crankyblondecoder/pico-boost/hardware/automotive_pi_pico_input_protect.ods

12V to Pico Input Calcs for ESD
 |  |  |  | Power, max supply (W)
Load Dump Max V | 120 | R1 min | 20449
-ve spike V | -150 | R1 Actual | 47000 | 0.00033
 |  | I,R1 min @ LD Max V (mA) | 1.41
Min supply V | 11.5 | R2 Actual | 100000 | 0.00070
Max supply V | 14.5 | R3 Ideal | 22936
 |  | R3 Actual | 20000 | 0.00014
Diode (1n4148) Vf @ 0.1mA | 0.5 | I,T1 @ T1 Breakdown Max (mA) | 0.97
Pin V | 3.3
 |  | D1, If @ Min Supply | 0.07
TVS Diode min current (mA) | 1 | D1, If @ Max Supply | 0.08
TVS Diode Standoff (V) | 43.6
TVS Diode Breakdown Min | 48.5 | OA v+ @ Min Supply | 1.32
TVS Diode Breakdown Max | 53.6 | OA v+ @ Max Supply | 1.68
TVS Forward Voltage | 3.5
TVS Forward Amperage | 50 | R6 min @ -ve spike | 43000
 |  | R6 Actual | 51000 | 0.00036
R1 and R6 Max Power (W) | 0.25
 |  | I,T1 @ -ve spike (mA) | 1.53
Opamp V+ | 5.0 | Vf, T1 @ -ve spike | 0.11
Opamp V- | 0.0 | OA v+ @ -ve spike | -0.0179
Opamp v+ max | 10.0
Opamp v+ min | -0.5 | R4 Actual | 20000 | 0.00035
Opamp v- ref | 0.5 | R5 Ideal | 4988
 |  | R5 Actual | 5100 | 0.00009
 |  | OA v- @ Pin (V) | 0.67
 |  | I,R4/R5 (mA) | 0.13
