crankyblondecoder/pico-boost/hardware/12v_protected_logic_input.jpg

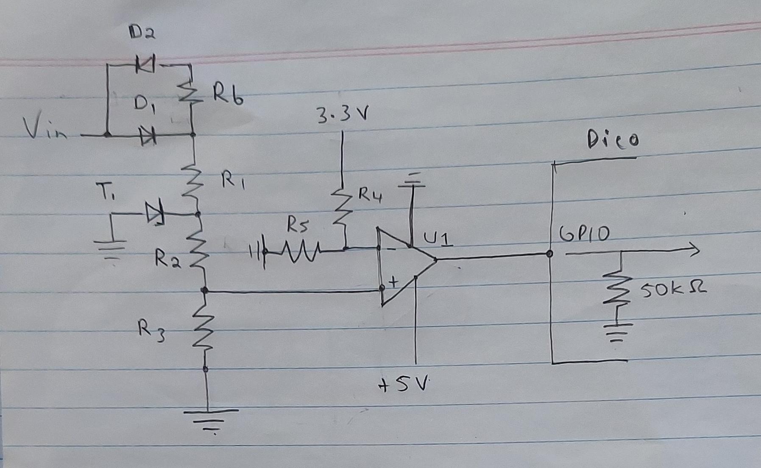
hardware/12v_protected_logic_input.jpg
