crankyblondecoder/pico-boost/src/pico_boost.cpp

#include "pico/stdlib.h"
#include <stdio.h>
#include "hardware/adc.h"
#include "hardware/gpio.h"
#include "hardware/i2c.h"
#include "hardware/regs/intctrl.h"
#include "pico/multicore.h"
#include "pico/time.h"

#include "gpioAlloc.hpp"
#include "BoostControl.hpp"
#include "BoostOptions.hpp"

/** The ADC channel used to get VSYS voltage. */
#define VSYS_REF_CHANNEL 3

#define ON_BOARD_LED_FLASH_TIME_US 500000

bool onBoardLedOn = true;
absolute_time_t lastonBoardLedToggleTime;

bool debugMsgActive = true;

// Debug flag to get around timers being a pain. Set during debug only.
bool debug = false;

/** Single boost control instance, instantiated on core 1. */
BoostControl* boostControl = 0;

BoostOptions* boostOptions = 0;

void __core1_entry();

/**
 * Program for Pi Pico that controls boost.
 */
int main()
{
	// Make sure disabled interrupts wake up WFE via the SEVONPEND flag of the SCR register.
	// See "M0PLUS: SCR Register" in RP2040 Datasheet.
	// SEVONPEND needs to be set. This allows WFE to wake up on pending interrupt even if disabled.
	uint32_t* scrRegAddr = (uint32_t*)(PPB_BASE + 0xed10);
	*scrRegAddr |= 0x10;

	// Must happen for serial stdout to work.
	stdio_init_all();

	// Setup ADC.
	adc_init();

	// Setup GPIO for boost options. Done here so it doesn't get forgotten when allocating GPIO.
	gpio_init(BOOST_OPTIONS_TEST_ACTIVE_GPIO);
	gpio_set_dir(BOOST_OPTIONS_TEST_ACTIVE_GPIO, GPIO_OUT);
	gpio_put(BOOST_OPTIONS_TEST_ACTIVE_GPIO, false);

	// Push GPIO pin 23 (SMPS Mode) high to disable power saving, which causes noise in the ADC.
	gpio_init(23);
	gpio_set_dir(23, GPIO_OUT);
	gpio_put(23, true);

	// Setup i2c bus 0.
	// Note: i2c is open drain so it requires pull up resistors on both pins.
	// Note: i2c_write_timeout_us can be used for multiple bytes. Be aware of page size write limits on the chip.
	// Note: i2c_read_timeout_us can be used for multiple bytes. Be aware of page size write limits on the chip.
	i2c_init(i2c0, 400000);

	gpio_init(I2C_BUS0_SDA_GPIO);
    gpio_set_function(I2C_BUS0_SDA_GPIO, GPIO_FUNC_I2C);
    gpio_pull_up(I2C_BUS0_SDA_GPIO);

    gpio_init(I2C_BUS0_SCL_GPIO);
    gpio_set_function(I2C_BUS0_SCL_GPIO, GPIO_FUNC_I2C);
    gpio_pull_up(I2C_BUS0_SCL_GPIO);

	// Start second core which will read sensor data and control the wastegate solenoid.
	multicore_launch_core1(__core1_entry);

	// Use onboard LED to indicate startup status.
	gpio_init(PICO_DEFAULT_LED_PIN);
	gpio_set_dir(PICO_DEFAULT_LED_PIN, GPIO_OUT);
	gpio_put(PICO_DEFAULT_LED_PIN, onBoardLedOn);

	// Wait for boost control to be instantiated on core 1.
	while(!boostControl)
	{
		sleep_us(10);
	}

	// Wait for boost control to be ready for processing.
	while(!boostControl -> ready())
	{
		sleep_us(10);
	}

	boostOptions = new BoostOptions(boostControl);

	lastonBoardLedToggleTime = get_absolute_time();

	// Main processing loop. Used for user interaction.
	while(1)
	{
		absolute_time_t curTime = get_absolute_time();
		if(absolute_time_diff_us(lastonBoardLedToggleTime, curTime) >= ON_BOARD_LED_FLASH_TIME_US)
		{
			onBoardLedOn = !onBoardLedOn;
			lastonBoardLedToggleTime = curTime;
			gpio_put(PICO_DEFAULT_LED_PIN, onBoardLedOn);
		}

		boostOptions -> poll();
	}
}

void __core1_entry()
{
	boostControl = new BoostControl();

	while(1)
	{
		boostControl -> poll();
	}
}
