crankyblondecoder/pico-boost/(commit log)

2025-03-30 Map sensor reading okay.
2025-04-11 Added switch class.
2025-04-13 EOS Broken. Moving more stuff out into modules.
    [pico_boost.cpp, pico_boost_control.cpp, pico_boost_control.hpp, pico_boost_options.cpp, pico_boost_options.hpp]
2025-04-14 Abstracted ADC out. Started on boost options.
2025-04-24 EOS. Incomplete. Starting 24CS256 EEPROM driver.
2025-05-08 Fix for making sure all boost values are relative to std atm.
    [BoschMap_0261230119.cpp, pico_boost_control.cpp, pico_boost_control.hpp]
2025-05-10 Starting PWM class.
2025-05-16 Fixed -ve sign flutter on display.
    [pico_boost_options.cpp]
2025-05-21 EOS. Incomplete. Broken. Adding write to 24CS256 EEPROM.
    [Eeprom_24CS256.cpp, pico_boost.cpp, pico_boost_control.cpp, pico_boost_control.hpp, pico_boost_options.cpp, pico_boost_options.hpp]
2025-06-13 PWM ready for testing.
2025-06-22 PWM output from GPIO pin is testing okay.
2025-06-30 EOS. Starting to implement PID algo.
    [pid_calcs.ods]
2025-07-20 Adding Kicad hardware designs.
    [pico_boost.kicad_pcb, pico_boost.kicad_sch]
2025-07-22 Added protected input calcs.
    [automotive_pi_pico_input_protect.ods]
2025-07-22 Updated Kicad files.
    [RP2040_minimal_r2-BOM.xlsx, RP2040_minimal_r2.kicad_pcb, RP2040_minimal_r2.kicad_sch, pico_boost.kicad_pcb, pico_boost.kicad_sch]
2025-07-29 Pulled GPIO allocations into single file.
    [automotive_pi_pico_input_protect.ods]
2025-08-18 Broken. Still adding boost preset control.
    [TM1637_pico.cpp, pico_boost_control.cpp, pico_boost_control.hpp, pico_boost_options.cpp, pico_boost_options.hpp]
2025-08-21 PID Algo first draft implemented but not tested.
2025-08-21 Added factory reset option. Not tested yet.
    [pico_boost_options.cpp]
2025-08-31 Fixed initial switch state bug.
    [BoostOptions.cpp, PicoSwitch.cpp]
2025-09-13 EOS. Incomplete. Broken. Still trying to implement 5-way nav switch.
    [BoostControl.cpp, BoostControl.hpp, BoostOptions.cpp, BoostOptions.hpp, TM1637_pico.cpp, gpioAlloc.hpp]
2025-09-17 Boost options testing okay for nav button and preset select.
2025-09-17 Added core0 main loop active led flash.
